EMBKSM/RV32-FullStack/docs/figs/fig_readback.png

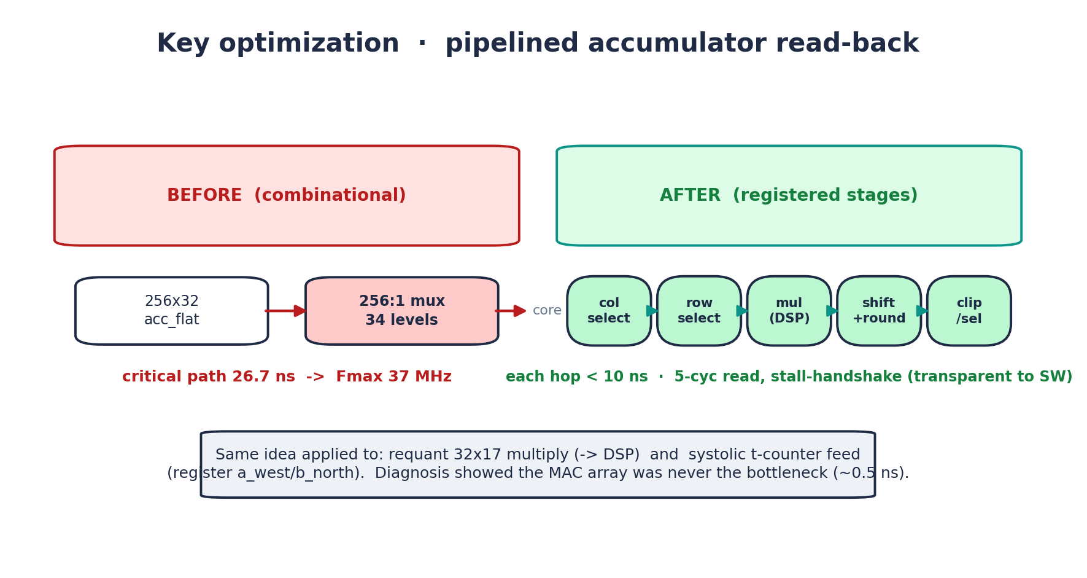
docs/figs/fig_readback.png
