EMBKSM/RV32-FullStack/docs/figs_corp/bg_blue.png

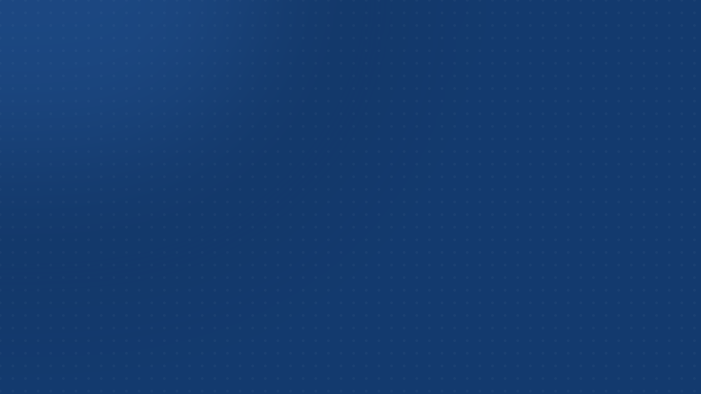
docs/figs_corp/bg_blue.png
