EMBKSM/RV32-FullStack/sim/tb_pmod_bva.vhd

-- =====================================================================
-- tb_pmod_bva.vhd  -  self-checking 3-point boundary-value testbench for the
-- Pmod peripherals, exercised through the real mmio_bridge register bus.
--
-- Loopbacks: SPI MISO<-MOSI, UART RX<-TX, I2C bus idle-high (no slave: a READ
-- returns 0xFF and a WRITE just completes, which is the defined no-device path).
-- GPIO: outputs observed on gpio_o/gpio_t; inputs driven on tb_gpio_i.
--
-- Compile with VHDL-2008 (to_hstring, std.env). See run_bva.bat.
-- Prints "PASS <id>" / "FAIL <id> ..." per case and a final
-- "BVA SUMMARY: TESTS=<n> FAIL=<m>".
-- =====================================================================
library IEEE;
use IEEE.STD_LOGIC_1164.ALL;
use IEEE.NUMERIC_STD.ALL;
library STD;
use STD.ENV.ALL;

entity tb_pmod_bva is end tb_pmod_bva;

architecture sim of tb_pmod_bva is
    constant GPIO_W : integer := 22;
    signal clk   : std_logic := '0';
    signal reset : std_logic := '1';

    signal c_addr, c_wdata, c_rdata : std_logic_vector(31 downto 0) := (others=>'0');
    signal c_wstrb : std_logic_vector(3 downto 0) := "1111";
    signal c_we, c_re, c_stall : std_logic := '0';
    signal d_rdata : std_logic_vector(31 downto 0) := (others=>'0');
    signal d_stall : std_logic := '0';
    signal d_addr, d_wdata : std_logic_vector(31 downto 0);
    signal d_wstrb : std_logic_vector(3 downto 0);
    signal d_we, d_re : std_logic;
    signal led_o : std_logic_vector(3 downto 0);
    signal sw_i, btn_i : std_logic_vector(3 downto 0) := (others=>'0');
    signal gpio_i, gpio_o, gpio_t : std_logic_vector(GPIO_W-1 downto 0) := (others=>'0');
    signal spi0_sclk,spi0_mosi,spi0_ss_n,spi0_miso : std_logic;
    signal spi1_sclk,spi1_mosi,spi1_ss_n,spi1_miso : std_logic;
    signal i2c0_scl_in,i2c0_scl_oe,i2c0_sda_in,i2c0_sda_oe : std_logic;
    signal i2c1_scl_in,i2c1_scl_oe,i2c1_sda_in,i2c1_sda_oe : std_logic;
    signal uart_tx, uart_rx : std_logic;
    signal pwm_o : std_logic_vector(3 downto 0);
    signal tb_gpio_i : std_logic_vector(GPIO_W-1 downto 0) := (others=>'0');

    constant SYS:integer:=16#00#; constant GPIO:integer:=16#20#;
    constant SPI0:integer:=16#40#; constant SPI1:integer:=16#60#;
    constant I2C0:integer:=16#80#; constant I2C1:integer:=16#A0#;
    constant UART:integer:=16#C0#; constant PWM:integer:=16#E0#;
begin
    dut : entity work.mmio_bridge
        generic map (LED_W=>4, SW_W=>4, BTN_W=>4, GPIO_W=>GPIO_W)
        port map (clk=>clk, reset=>reset,
            c_addr=>c_addr, c_wdata=>c_wdata, c_wstrb=>c_wstrb, c_we=>c_we, c_re=>c_re,
            c_rdata=>c_rdata, c_stall=>c_stall,
            d_addr=>d_addr, d_wdata=>d_wdata, d_wstrb=>d_wstrb, d_we=>d_we, d_re=>d_re,
            d_rdata=>d_rdata, d_stall=>d_stall,
            led_o=>led_o, sw_i=>sw_i, btn_i=>btn_i,
            gpio_i=>gpio_i, gpio_o=>gpio_o, gpio_t=>gpio_t,
            spi0_sclk=>spi0_sclk,spi0_mosi=>spi0_mosi,spi0_ss_n=>spi0_ss_n,spi0_miso=>spi0_miso,
            spi1_sclk=>spi1_sclk,spi1_mosi=>spi1_mosi,spi1_ss_n=>spi1_ss_n,spi1_miso=>spi1_miso,
            i2c0_scl_in=>i2c0_scl_in,i2c0_sda_in=>i2c0_sda_in,i2c0_scl_oe=>i2c0_scl_oe,i2c0_sda_oe=>i2c0_sda_oe,
            i2c1_scl_in=>i2c1_scl_in,i2c1_sda_in=>i2c1_sda_in,i2c1_scl_oe=>i2c1_scl_oe,i2c1_sda_oe=>i2c1_sda_oe,
            uart_tx=>uart_tx, uart_rx=>uart_rx, pwm_o=>pwm_o);

    spi0_miso <= spi0_mosi;
    spi1_miso <= spi1_mosi;
    uart_rx   <= uart_tx;
    gpio_i    <= tb_gpio_i;
    i2c0_scl_in <= not i2c0_scl_oe;   -- idle-high bus, no slave
    i2c0_sda_in <= not i2c0_sda_oe;
    i2c1_scl_in <= not i2c1_scl_oe;
    i2c1_sda_in <= not i2c1_sda_oe;

    clk <= not clk after 10 ns;       -- 50 MHz

    stim : process
        variable n_tests : integer := 0;
        variable n_fail  : integer := 0;
        variable rd : std_logic_vector(31 downto 0);
        variable hc : integer;

        procedure mwr(off:integer; d:std_logic_vector(31 downto 0)) is
        begin
            c_addr <= std_logic_vector(to_unsigned(16#10000000#+off,32));
            c_wdata<= d; c_we<='1'; c_re<='0';
            wait until rising_edge(clk);
            c_we<='0';
            wait until rising_edge(clk);
        end procedure;

        procedure mrd(off:integer; res:out std_logic_vector(31 downto 0)) is
        begin
            c_addr <= std_logic_vector(to_unsigned(16#10000000#+off,32));
            c_re<='1'; c_we<='0';
            wait until rising_edge(clk);
            res := c_rdata;
            c_re<='0';
            wait until rising_edge(clk);
        end procedure;

        procedure chk(id:string; got,exp:std_logic_vector(31 downto 0)) is
        begin
            n_tests := n_tests + 1;
            if got = exp then
                report "PASS " & id;
            else
                report "FAIL " & id & " got=" & to_hstring(got) & " exp=" & to_hstring(exp)
                    severity error;
                n_fail := n_fail + 1;
            end if;
        end procedure;

        procedure chk_lo(id:string; b:std_logic) is   -- expect a single bit = '0'
        begin
            n_tests := n_tests + 1;
            if b='0' then report "PASS " & id;
            else report "FAIL " & id severity error; n_fail := n_fail + 1; end if;
        end procedure;

        procedure spi_xfer(base:integer; divv:integer; ctrl:integer; txb:integer;
                           res:out std_logic_vector(31 downto 0)) is
            variable s : std_logic_vector(31 downto 0);
        begin
            mwr(base+8,  std_logic_vector(to_unsigned(divv,32)));
            mwr(base+0,  std_logic_vector(to_unsigned(ctrl,32)));
            mwr(base+12, std_logic_vector(to_unsigned(txb,32)));      -- start
            for i in 0 to 200000 loop mrd(base+4,s); exit when s(0)='0'; end loop;
            mrd(base+16,res);
        end procedure;

        procedure spi_suite(base:integer; tag:string) is
            variable r : std_logic_vector(31 downto 0);
            variable s : std_logic_vector(31 downto 0);
        begin
            -- DIV=0 (true minimum): verify the engine RUNS and the transfer COMPLETES
            -- (busy returns to 0). RX is NOT asserted here: with MOSI looped to MISO
            -- through the master's 2-FF input synchronizer, the bit period at DIV=0/1
            -- is within the 2-clk sync latency, so the first sampled bit reads the stale
            -- pre-launch value. That is a loopback artifact (a real slave's MISO is
            -- sampled correctly); data integrity is checked at DIV>=2 below.
            mwr(base+8, x"00000000"); mwr(base+0, x"00000000"); mwr(base+12, x"000000FF");
            for i in 0 to 100000 loop mrd(base+4,s); exit when s(0)='0'; end loop;
            chk_lo(tag&"-div0-done", s(0));
            -- data integrity: lowest loopback-valid divider, then bit-ordering at nominal
            spi_xfer(base,2,  0, 16#FF#, r); chk(tag&"-div2-ff", r, x"000000FF"); -- min valid
            spi_xfer(base,3,  0, 16#01#, r); chk(tag&"-div3-01", r, x"00000001"); -- LSB
            spi_xfer(base,24, 0, 16#80#, r); chk(tag&"-nom-80",  r, x"00000080"); -- MSB first
            spi_xfer(base,24, 0, 16#AA#, r); chk(tag&"-txAA",    r, x"000000AA"); -- ordering
            spi_xfer(base,8,  3, 16#A5#, r); chk(tag&"-mode3",   r, x"000000A5"); -- CPOL/CPHA=1
        end procedure;
    begin
        reset<='1'; wait for 100 ns; wait until rising_edge(clk);
        reset<='0'; wait until rising_edge(clk);

        -- ---------- SPI0 / SPI1 ----------
        spi_suite(SPI0,"SPI0");
        spi_suite(SPI1,"SPI1");

        -- ---------- GPIO ----------
        mwr(GPIO+0, x"FFFFFFFF"); mrd(GPIO+0, rd); chk("GPIO-dir-trunc", rd, x"003FFFFF");
        mwr(GPIO+4, x"002AAAAA"); wait until rising_edge(clk);
        chk("GPIO-o-pat",  std_logic_vector(resize(unsigned(gpio_o),32)), x"002AAAAA");
        chk("GPIO-t-zero", std_logic_vector(resize(unsigned(gpio_t),32)), x"00000000");
        mwr(GPIO+0, x"00200001"); mwr(GPIO+4, x"00200001"); wait until rising_edge(clk);
        chk("GPIO-o-edge", std_logic_vector(resize(unsigned(gpio_o),32)), x"00200001");
        chk("GPIO-t-edge", std_logic_vector(resize(unsigned(gpio_t),32)), x"001FFFFE");
        mwr(GPIO+0, x"00000000");
        tb_gpio_i <= "10" & x"AAAAA";
        wait until rising_edge(clk); wait until rising_edge(clk); wait until rising_edge(clk);
        mrd(GPIO+8, rd); chk("GPIO-in-pat", rd, x"002AAAAA");

        -- ---------- UART ----------
        mwr(UART+0, x"00000001"); mrd(UART+0, rd); chk("UART-div-min", rd, x"00000001");
        mwr(UART+0, x"0000FFFF"); mrd(UART+0, rd); chk("UART-div-max", rd, x"0000FFFF");
        mwr(UART+0, x"00000010");                      -- DIV=16 for loopback
        for v in 0 to 5 loop
            case v is
                when 0=> mwr(UART+8, x"00000000");
                when 1=> mwr(UART+8, x"00000001");
                when 2=> mwr(UART+8, x"00000055");
                when 3=> mwr(UART+8, x"000000AA");
                when 4=> mwr(UART+8, x"000000FE");
                when others=> mwr(UART+8, x"000000FF");
            end case;
            for i in 0 to 100000 loop mrd(UART+4, rd); exit when rd(1)='1'; end loop;
            mrd(UART+12, rd);
            case v is
                when 0=> chk("UART-rx00", rd, x"00000000");
                when 1=> chk("UART-rx01", rd, x"00000001");
                when 2=> chk("UART-rx55", rd, x"00000055");
                when 3=> chk("UART-rxAA", rd, x"000000AA");
                when 4=> chk("UART-rxFE", rd, x"000000FE");
                when others=> chk("UART-rxFF", rd, x"000000FF");
            end case;
        end loop;

        -- ---------- PWM ----------
        mwr(PWM+0, x"00000000"); mwr(PWM+4, x"00000064"); mwr(PWM+8, x"00000000");
        mwr(PWM+0, x"00000001");                       -- enable ch0, PERIOD=100, DUTY=0
        hc := 0;
        for i in 0 to 199 loop wait until rising_edge(clk); if pwm_o(0)='1' then hc:=hc+1; end if; end loop;
        chk("PWM-duty0", std_logic_vector(to_unsigned(hc,32)), x"00000000");
        mwr(PWM+8, x"00000064");                       -- DUTY=PERIOD -> 100%
        hc := 0;
        for i in 0 to 199 loop wait until rising_edge(clk); if pwm_o(0)='1' then hc:=hc+1; end if; end loop;
        chk("PWM-duty100", std_logic_vector(to_unsigned(hc,32)), x"000000C8");
        mwr(PWM+8, x"000000C8");                        -- DUTY>PERIOD -> saturate 100%
        hc := 0;
        for i in 0 to 199 loop wait until rising_edge(clk); if pwm_o(0)='1' then hc:=hc+1; end if; end loop;
        chk("PWM-sat", std_logic_vector(to_unsigned(hc,32)), x"000000C8");
        mwr(PWM+4, x"0FFFFFFF"); mrd(PWM+4, rd); chk("PWM-period-trunc", rd, x"00FFFFFF");

        -- ---------- I2C0 (FSM/decode/busy on an idle-high bus) ----------
        mwr(I2C0+8, x"0000007C"); mrd(I2C0+8, rd); chk("I2C-div",  rd, x"0000007C");
        mwr(I2C0+12,x"000000A0"); mrd(I2C0+12,rd); chk("I2C-tx",   rd, x"000000A0");
        mwr(I2C0+0, x"00000000"); mrd(I2C0+4, rd); chk_lo("I2C-cmd0-idle", rd(0)); -- empty cmd: no busy
        mwr(I2C0+12,x"000000A0"); mwr(I2C0+0, x"00000005");                        -- START|WRITE
        wait until rising_edge(clk); wait until rising_edge(clk);
        for i in 0 to 200000 loop mrd(I2C0+4, rd); exit when rd(0)='0'; end loop;
        chk_lo("I2C-wr-busyclr", rd(0));
        mwr(I2C0+0, x"00000008");                                                 -- READ, ACK=0
        for i in 0 to 200000 loop mrd(I2C0+4, rd); exit when rd(0)='0'; end loop;
        mrd(I2C0+16, rd); chk("I2C-rd-idle", rd, x"000000FF");

        report "BVA SUMMARY: TESTS=" & integer'image(n_tests) & " FAIL=" & integer'image(n_fail);
        assert n_fail = 0 report "BVA had failures" severity failure;
        finish;
    end process;
end sim;
