EMBKSM/RV32-FullStack/(commit log)

2026-04-27 feat: implement instruction fetch stage including program counter logic and cache address splitting components
2026-06-09 fix: fix ADDI gating and add synchronous reset to register_file
    - BUG-IFWB-001: Fix incorrect application of funct7[5] in ADDI instructions
    - BUG-IFWB-002: Fix state leakage between programs by adding synchronous reset to register_file
    - Completed the 1st integration test
    [register_file.vhd, rv32_core.vhd, tb_register_file.sv, tb_rv32_core_if_wb.sv]
2026-06-09 fix: resolve D-cache store-miss bug and fix testbench state leakage
    [1st Integration Test Fixes]
    - RTL (dcache_controller): Add D_SWRITE state to write store word while maintaining stall after refill.
    - TB: Move dut_run preload timing to negedge to prevent instruction fetch race condition (PC=0).
    [2nd Integration Test Fixes]
    - TB: Append halt instruction (jal x0,0) to the end of programs to prevent rolling into stale memory.
    - TB: Implement data window (0x40~0x7c) zero-clearing before each test run to eliminate state leakage.
    Result: 2nd integration test fully completed (ALL PASS).
    [axi_slave_mem.vhd, cache_unit.vhd, dcache_controller.vhd, rv32_core.vhd, rv32_soc.vhd, tb_rv32_core_if_wb.sv, tb_rv32_soc.sv]
2026-06-09 feat: complete RV32I CPU (CSR/trap + FENCE.I) and package all blocks as IP
    RTL:
    - Integrate CSR (Zicsr) + trap (ECALL/EBREAK/MRET/illegal) into rv32_core EX
    - Rebuild I-cache from IF-line blocks: icache_unit + icache_data_array +
    icache_axi_adapter; swap into rv32_soc
    - Wire FENCE.I -> I-cache invalidate (one-shot ic_fence_i)
    Verify:
    - Add icache unit/integration TBs; fix stale tb_dcache_controller (D_SWRITE)
    - Python regression ALL GREEN (incl. fault-injection); full SoC xsim ALL PASS
    - VERIFICATION_REPORT_FINAL.md, run_all_xsim.bat
    IP:
    - package_all_ip.tcl / fix_icache_adapter_ip.tcl -> ip_repo/ (30 IPs)
    [address_aligner.vhd, alu.vhd, alu_control.vhd, axi_master.vhd, bcu.vhd, cache_controller.vhd, cache_unit.vhd, comparator.vhd]
2026-06-09 feat(bd): add pipeline-register + glue modules and package them as IP for BD assembly
    Hand-assembling rv32_core in IP Integrator from leaf IPs needs glue that lives
    inline in rv32_core.vhd (not packaged). Add it as standalone modules + IPs.
    bd_assembly/:
    - ifid_reg / idex_reg / exmem_reg / memwb_reg : pipeline boundary registers
    (extracted 1:1 from rv32_core; freeze/bubble/squash + EX/MEM CSR-fold)
    - id_decode_glue : ID field slices + funct7_5 gating + jalr + zimm + csr_we
    - fencei_oneshot : FENCE.I 1-cycle invalidate pulse
    - mux2_32 / mux3_32 / orgate2 / andn2 : datapath/control glue
    - BD_WIRING_GUIDE.md : stage-by-stage netlist + per-stage IP BOM
    - bd_mux_glue.vhd : deprecated (split in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
2026-06-11 feat(soc): host-controlled RV32 platform on Zynq PL — AXI-Lite control + MMIO, bitstream
    PL platform (ip_workspace/5_Platform/):
    - mmio_bridge : cache-bypass MMIO decode (LED out / SW,BTN in) on the data bus
    - rv32_ctrl_axi : AXI4-Lite control/status slave (load imem/dmem, cpu_reset/run/
    step, read register/PC/commit-diff/data) — §4 register map
    - rv32_platform : synthesizable PL top = rv32_core + I$/D$ + RAM + MMIO + ctrl,
    with single-step/run/halt control
    mem: axi_slave_mem reworked for synthesis — synchronous (prefetch-registered)
    reads + unified byte-enable write => infers BRAM (was LUTRAM); added a
    registered host dump-read port. E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
    [address_aligner.vhd, alu.vhd, alu_control.vhd, axi_master.vhd, axi_slave_mem.vhd, bcu.vhd, cache_controller.vhd, cache_unit.vhd]
2026-06-16 feat(host): PC assembler/GUI + console + PS monitor for the AXI-Lite RV32 platform
    Host-side toolchain that assembles, loads and runs programs over UART -> the PS
    monitor -> the AXI-Lite control slave (no JTAG needed for run/debug):
    - host_app/rv32_gui.py : PySide6 assembler + register/memory/peripheral view,
    load/reset/run/step with a live register map.
    - host_app/rv32_console.py : headless assemble+load+run for scripting/regression.
    - ps_firmware/rv32_monitor.c: OCM-resident PS monitor, r/i/d/g/s/x/m/p/c/t command
    protocol at 115200 baud.
    GUI fixes from board bring-up:
    - regsReady = Signal(object) (was Signal(dict)): Shiboken c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
    [rv32_console.py, rv32_gui.py, rv32_monitor.c]
2026-06-16 feat(soc): AXI-Lite read-back of board peripherals (LED/SW/BTN)
    rv32_ctrl_axi: add R registers 0x38 LED / 0x3C SW / 0x40 BTN so the host GUI shows
    live board-peripheral state next to the CPU register/PC/commit read-back.
    ip_workspace source + packaged ip_repo copy; docs/SOC_PLATFORM_DESIGN.md section 4
    register map updated.
2026-06-16 test(cpu): re-verify full RV32I against the ISS golden model
    All 39 RV32I instructions (raw) + 20 directed programs + 100 random programs cross-
    checked against the instruction-set simulator: 39/39, 20/20, 100/100 PASS. Confirms
    the core and cached-memory path are sound -- the bring-up faults were all host/GUI/
    board-side, not RTL.
    - verification/tb_ps_regress.sv harness; BOARD_VERIFICATION_REPORT.md writeup.
2026-06-16 chore(ps): QSPI-boot scripts + DDR DQS errata workaround (PARKED - board HW fault)
    flash/: FSBL + bootgen + program_flash scripts for standalone QSPI boot. Applied the
    DQS_TO_CLK_DELAY negative-value workaround (DQS=0.0; Xilinx AR53039 / Digilent PR#25)
    and regenerated ps7_init. program_flash still failed in u-boot and a byte-lane-3
    read-back fault reproduced -> genuine DDR hardware fault on this board (RMA). PARKED:
    the JTAG run/debug flow needs no DDR, so this does not block the platform.
    (generated ps7_init, BOOT.bin, ELFs and the Vitis workspace are git-ignored.)
2026-06-16 feat(pl): MMIO Pmod peripherals on JA-JE -- 2x SPI, 2x I2C, UART, PWM, GPIO; bitstream
    PL peripherals (ip_workspace/5_Platform/) mapped into the 0x1000_0000 MMIO window
    (block=addr[7:5], reg=addr[4:2]) so RV32 assembly drives them with plain lw/sw -- no
    PS firmware/monitor/GUI change:
    - spi_master x2 (JA/JB @0x40/0x60): 8-bit full-duplex, CPOL/CPHA modes 0-3, clock
    divider, auto/manual SS, 2-FF MISO sync, busy-guarded start.
    - i2c_master x2 (JC/JD @0x80/0xA0): open-drain, START/repeated-START/STOP/WR/RD/ACK
    FSM, prescale, clock-stretch aware, RXACK capture.
    - uart_lite (JE @0xC0): 8-N-1, baud divisor, mid-bit RX sampling, RX_VALID/OVERRUN.
    - pwm_gen (JE @0xE0): 4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
2026-06-16 fix(host): robust assembler + fix README SPI example
    Assembler (rv32_gui.py and rv32_console.py, kept in sync):
    - li now assembles full 32-bit immediates (lui+addi) instead of silently
    truncating to 12 bits; lui-only when the low 12 bits are zero; correct
    signed remainder including the round-up / negative-low case.
    - add pseudo-branches beqz/bnez/bgez/bltz/blez/bgtz -> base branch vs x0.
    - range-check every immediate and reject out-of-range instead of masking:
    I-type ALU + load/store offsets (12-bit signed), shifts (shamt 0..31),
    lui/auipc (20-bit), branches (+-4 KiB, even), jal (+-1 MiB, even).
    - mem_operand rejects bare-hex offsets like ff(x1) with a clear message
    (require 0x for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
    [rv32_console.py, rv32_gui.py, test_assembler.py]
2026-06-18 feat(npu): INT8 systolic GEMM accelerator + LUTRAM caches + generic 16x16 scale-up
    PL area optimization
    - Convert I$/D$ data arrays to LUTRAM (distributed RAM) to free slices for the NPU.
    NPU (INT8 output-stationary systolic GEMM, uncached MMIO slave @ 0x3000_0000)
    - npu_pe: DSP48E1 INT8 MAC (DSP_USE generic selects DSP vs LUT fabric).
    - npu_array: NxN mesh, generic N + DSP_BUDGET hybrid DSP/LUT mapping.
    - npu_top: control FSM, skew feeder, distributed-RAM scratchpads, MMIO decode,
    on-chip requantization (INT32 -> mult/shift/clip -> INT8, CFG @ 0x000C).
    - mmio_bridge: NPU window decode (is_npu, addr[31:28]=0x3); now wires npu_top16.
    16x16 scale-up
    - Parameterized array (generic N, defaul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
2026-06-22 feat(npu): on-board 16x16 GEMM verified via ctrl_axi @30.3MHz + arch diagram
    ctrl_axi-direct JTAG drive bypasses dead DDR/OCM: load RV32 imem, run, read C. 2x2 tile GEMM on real XC7Z020 => C=[[39,53],[17,23]] matches golden. Key: configparams force-mem-access 1 enables XSDB PL-AXI access. Adds jtag_gemm_test.tcl, npu16_demo.s, BOARD_GEMM_RESULT.md, run_*.bat, architecture_block_diagram.svg, HANDOFF board-bringup.
2026-06-22 perf(npu): pipeline NPU read-back -> Fmax 37->94.3 MHz (16x16 SoC)
    Only failing paths were the NPU read-back, not the MAC array (PE->PE ~0.5ns). Registered pipeline stages, transparent to SW via mem_stall/rd_valid handshake: (1) 256:1 acc_flat select -> col/row stages (26.7->13.3ns, 37->75MHz, build 1h17m->8min); (2) requant 32x17 multiply -> mul(DSP)/shift/clip stages (WNS -3.29->-0.60ns @100MHz -> Fmax 94.3MHz, failing EPs 3196->817). npu_top 5-cycle read FSM + re/rd_valid; mmio_bridge stalls NPU reads. Re-verified 18,688/0. Board op 90.9MHz (FCLK0/11). Adds PERFORMANCE_FMAX.md, build/analyze tcl, jtag_gemm_test_100, rv32_16x16_100mhz.bit.
    [address_aligner.vhd, alu.vhd, alu_control.vhd, axi_master.vhd, bcu.vhd, cache_controller.vhd, comparator.vhd, control_unit.vhd]
2026-06-22 docs(npu): board test prepped @90.9MHz (FCLK0/11); JTAG/DAP degraded -> power-cycle pending
    3 board-test attempts hit DAP AHB AP transaction error (no A9 targets) = recurring board JTAG degradation needing a power-cycle; not a logic issue (94.3MHz proven in sim 18,688-check + post-route timing). jtag_gemm_test_100.tcl set to 90.9MHz (0x00100B00) with the 94MHz bitstream, self-validating. Cleans .git litter from sandbox commits.
    [mmio_bridge.vhd, npu_top.vhd, tb_npu_scale16.sv]
2026-06-22 test(npu): board GEMM PASS @90.9MHz on real XC7Z020 (94MHz build, C=39/53/17/23)
    After power-cycle: ctrl_axi drives RV32+16x16 NPU, reads C=[[39,53],[17,23]]=golden, BOARD-GEMM-90MHZ PASS, xsct exit=0. Fmax-94.3MHz pipelined-readback build runs correctly on silicon @90.9MHz (FCLK0/11); 5-cycle stall handshake works end-to-end.
    [mmio_bridge.vhd, npu_top.vhd, tb_npu_scale16.sv]
2026-06-22 perf(npu): close 100 MHz + board-verify (register scratchpad feed) -- Fmax 37->100
    Worst paths were ALL the systolic t-counter feed (t_reg->(t-n)->scratchpad->DSP A), not the core. Registered a_west/b_north in npu_top: path split at a flop, input stream shifts 1 cycle (t_last+1), bit-identical (18,688-check pass). WNS -0.602->+0.085ns @100MHz, 817->0 failing EPs. 100MHz=FCLK0/10. BOARD @100MHz GEMM C=[[39,53],[17,23]]=golden PASS. rv32_16x16_100mhz.bit=100MHz build; 94mhz_verified.bit preserves v3.
2026-06-22 perf(npu): close 100 MHz + board-verify (register scratchpad feed) -- Fmax 37->100
    Worst paths were ALL the systolic t-counter feed (t_reg->(t-n)->scratchpad->DSP A), not the core. Registered a_west/b_north in npu_top: long path split at a flop, input stream shifts 1 cycle uniformly (t_last+1), bit-identical (18,688-check pass). WNS -0.602->+0.085ns @100MHz, 817->0 failing endpoints; new worst path core-store->NPU-scratchpad-write +0.085 (met). 100MHz=FCLK0/10 (no MMCM). BOARD @100MHz: ctrl_axi GEMM C=[[39,53],[17,23]]=golden, PASS, xsct exit=0. rv32_16x16_100mhz.bit=100MHz build; rv32_16x16_94mhz_verified.bit=v3 94MHz backup. Consolidates partial sandbox-commit state.
    [mmio_bridge.vhd, npu_top.vhd, tb_npu_scale16.sv]
2026-06-23 perf(clk): PL MMCM (FCLK0 100->106) -> board-verified 106 MHz; retiming pushes Fmax to 110.8
    Beyond the clean 100MHz: synthesis retiming (Flow_PerfOptimized_high) lifts Fmax 100.9->110.8 MHz. New wall = RV32 load-use hazard path (exmem_reg_write->ifid CE, ~75% route) -- fundamental to the 5-stage pipeline; blind Pblock floorplan was neutral. 110.8 doesn't land on a clean FCLK0 divisor (/9=111.1 too fast, /10=100 wastes it), so a PL MMCM (clk_wiz in rv32_top.bd) synthesizes 106 MHz: FCLK0(100)->MMCM->106->PL. WNS -0.118ns @106 slow-corner (4 EPs) closes on real silicon: on-board ctrl_axi GEMM C=[[39,53],[17,23]]=golden, BOARD-GEMM-MMCM-106MHZ PASS, xsct exit=0. Adds build_npu16_mmcm/maxf/fp.t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
2026-06-24 fix(clk)+feat(gui,docs): clean 106 MHz close (0 critical warnings), dark GUI restyle, result deck
    Timing — the 106 MHz MMCM build now MEETS timing AND has a clean methodology
    report (was WNS -0.118 ns with 2 Critical Warnings):
    * Root-caused the 2 methodology Critical Warnings (TIMING-2 / TIMING-4): the
    clk_wiz IP re-created a primary clock on its input pin clk_in1, which the PS
    clock clk_fpga_0 (100 MHz) already drives -> redundant clock redefinition on
    the clock tree. Removed the redundant `create_clock [get_ports clk_in1]`
    (+ set_input_jitter) so clk_fpga_0 is the single master and the MMCM derives
    106 MHz from it.
    * Re-closed timing at the synthesis root (not an impl-stage ba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
2026-06-25 refactor(repo): standardize layout (rtl/sim/fpga/sw/docs) + untrack generated artifacts
    Reorganize into a conventional hierarchy and stop tracking regenerable build output.
    Layout:
    rtl/{core,npu,soc,common} <- ip_workspace/ (single VHDL source of truth)
    sim/ <- verification/ (TB sources + py harnesses + .f lists)
    fpga/{scripts,constraints,flash} <- build TCL, XDC, boot/jtag scripts
    sw/{firmware,host} <- ps_firmware (A9 monitor) + host_app (Python GUIs)
    docs/ <- all .md specs/reports + figures (root docs consolidated)
    archive/legacy_bd/ <- bd_assembly (dead hand-wired BD glue, kept for refer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
2026-06-25 feat(gpu): SIMT-lite vector coprocessor (8-lane, LUT-based) @ 0x4xxx_xxxx
    A small data-parallel "GPU" attached to the RV32 SoC like the NPU: one
    instruction stream drives 8 lanes in lockstep with a per-lane predicate
    mask (SIMT-lite). Lanes are LUT-based (multiplier use_dsp="no") so all
    DSP48 stay with the NPU -- fits the ~38k free LUT / 18 free DSP headroom.
    RTL (rtl/gpu/): gpu_pkg (ISA), gpu_lane (32-bit ALU + LUT multiplier),
    gpu_core (1-PC lockstep datapath, banked scratchpad, mask predication),
    gpu_top (MMIO slave: CTRL/STATUS/IMEM/scratchpad windows). Wired into
    rtl/soc/mmio_bridge.vhd as the 0x4 window -- twin of the NPU's 0x3,
    single-cycle, cache-bypassed.
    ISA: banked vector load/s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
2026-06-25 feat(multicore): dual-core RV32 cluster (SPMD, shared scratchpad + barrier)
    Two unmodified rv32_core instances (ideal memory, mem_stall=0) sharing one
    rv32_shared block: per-port hart id (A->0, B->1), one-shot barrier, and a
    shared scratchpad (A>B>T write priority), routed at data addr bit31=1
    (0x8000_0000+); bit31=0 is each core's private 4 KiB imem/dmem. No core
    edit (mhartid stays 0; the id comes from the shared block per port).
    Demo: the SAME SPMD program (sim/multicore/spmd.s, assembled by the project
    assembler) runs on both cores; each reads its hart id and computes its half
    of C[i]=A[i]+B[i] in the shared scratchpad -> hart0 does C[0..3], hart1
    C[4..7], result [11,22,..,88].
    Verify: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
2026-06-25 chore: track sim launcher scripts + gitignore exception
    The run_*.bat ignore (originally for the removed run_all_xsim.bat) was also
    hiding sim/gpu/run_gpu.bat and sim/multicore/run_dual.bat, which the README
    references. Add explicit !exceptions and track both launchers.
2026-06-26 refactor(gpu): 16x16 DSP multiply per lane (was 32x32 LUT) + synth notes
    OOC synthesis showed the use_dsp="no" 32x32 LUT multiply (x8 lanes) was
    impractical: ~16 min synth, ~16k LUT. Switch to a 16x16->32 signed multiply
    mapped to one DSP48E1 per lane -> 8 DSP total (fits the ~18 free after the
    NPU); "Finished Synthesize" drops to ~24 s. C golden model updated to match
    (16-bit operands; exact for the demo kernels -- ALL GOLDEN CHECKS PASS).
    docs/GPU_DESIGN.md gains a synthesis-notes section, also flagging the
    async-read scratchpad inferring 65536 FF -> backing the scratchpad/imem with
    BRAM (sync read) + mem_stall pipelining is the next implementation refinement.
    Sim correctness (xsim, all 3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
    [gpu_lane.vhd, gpu_model.c]
2026-06-28 perf(gpu): pipeline vector-ALU + register BRAM addr -> 100 MHz timing MET
    Close GPU OOC timing at 100 MHz (xc7z020-1): WNS -3.975 -> +0.032 ns,
    0 failing endpoints of 7825.
    - gpu_core: 3-cycle vector-ALU pipeline (S_RUN->S_EX->S_WB) isolates the
    16x16 DSP multiply in its own cycle; synth -retiming pulls the operand
    registers into the DSP A/B/CREG. (-3.975 -> -0.338)
    - gpu_core: register the scratchpad row index (ld_row_r); VLD becomes
    3-cycle / VST 2-cycle so the BRAM address port sits off the
    pc->imem->scalar-adder path. (-0.338 -> +0.032 MET; limiter now SADDI)
    - gpu_ooc.xdc: 10 ns (100 MHz) OOC clock. synth_impl_gpu.tcl: retiming +
    Explore place/route + stable phys_opt; post-ro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
    [gpu_core.vhd, tb_gpu.vhd]
2026-06-28 chore(multicore,repo): OOC timing analysis + Vivado scratch cleanup
    - docs/MULTICORE_TIMING.md: dual-core OOC findings. rv32_core meets 100 MHz
    (WNS +0.110 ns; 2261 LUT / 2815 FF / 0 BRAM / 0 DSP), so 2x core fits and
    closes. The shared scratchpad + private imem/dmem are combinational sim
    coding that needs BRAM backing for a real impl (same pattern as the GPU
    scratchpad fix; rv32_shared is 3-port so a bit more involved).
    - sim/{gpu,multicore}: track the OOC synth/impl + xsim run scripts (.tcl/.xdc).
    - .gitignore: ignore *.dmp, hs_err_pid*, clockInfo.txt (Vivado scratch).
    - remove stray Vivado scratch (hs_err crash dump + clockInfo.txt).
2026-06-28 docs(soc): full integration synth -- core+NPU+GPU fits @ DSP 218/220
    OOC impl of rv32_platform (core + caches + mmio_bridge -> NPU16 + GPU +
    peripherals) on xc7z020-1 @ 100 MHz:
    - Fits: 21368 LUT (40%) / 12761 FF (12%) / 16 BRAM (11%) / 218 DSP (99%).
    The GPU's 16 DSP slot into the ~18 free after the NPU's ~202.
    - Timing: WNS -0.220 ns, 12/58742 failing endpoints (plain flow, no
    retiming/Explore/phys_opt). Limiter = GPU-internal SBNZ/pc path, the same
    class the standalone GPU closed to +0.032 with those directives; closing
    the integration is the next step.
    - fpga/scripts/synth_platform_ooc.tcl + platform_ooc.xdc to reproduce.
2026-06-29 docs(soc): integration timing is DSP-congestion-bound at 99% (218/220)
    Closing the -0.220 ns integration WNS stalled: with DSP at 218/220 the
    place/route/phys_opt passes have almost no free fabric and grind for tens of
    minutes with the GPU pc/SBNZ path stuck (route ~69% of the path = pure
    congestion). That same path closes to +0.032 standalone, so it's a
    placement-congestion artifact, not logic.
    Recommended close (documented in SOC_INTEGRATION.md): GPU 16 -> 8 DSP (one
    DSP/lane doing A*B and A*B+C) for routing headroom -> 210/220; or a Pblock
    floorplan; or the full board-project build. Board precedent (core+NPU GEMM
    ran on silicon at WNS -0.118 @106MHz slow corner) => the integration is
    sil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
2026-06-29 Unified NPU/GPU fabric: GPU borrows 8 NPU PE DSPs (0 extra DSP)
    Dual-mode npu_pe: one DSP48E1 does NPU INT8 MAC (A*B+P accumulate) OR a GPU lane multiply-add (A*B+C), runtime mode-selected -> synth-proven exactly 1 DSP per PE. The 8 GPU lanes reuse 8 row-0 NPU PE DSPs over a shared bus (npu_array/top/top16 <-> gpu_core/top <-> mmio_bridge). Full 16x16 NPU + 8-lane GPU = 202 DSP (was 210 separate, won't route on XC7Z020); 202 = the silicon-proven core+NPU point. tb_unified: vadd / saxpy(VMUL) / relu / vmac(A*B+C) ALL PASS on the shared DSPs. See docs/UNIFIED_NPU_GPU.md.
    [gpu_core.vhd, gpu_lane.vhd, gpu_top.vhd, mmio_bridge.vhd, npu_array.vhd, npu_pe.vhd, npu_pe_dual_wrap.vhd, npu_top.vhd]
2026-06-29 Board bitstream: unified NPU/GPU SoC @100MHz (202 DSP, routed, WNS -0.054)
    Version-bump the platform IP on each package so Vivado re-synthesizes the unified fabric from current source (fixes the stale-cache 210-DSP build). Add the Zybo Z7-20 pin XDCs to the impl constraint set. xc7z020 result: 202/220 DSP, 0 failed nets, hold met (WHS +0.045), setup WNS -0.054 @100MHz after post-route phys_opt (Fmax ~99.5MHz). Bitstream fpga/flash/rv32_unified_100mhz.bit (3.9MB) generated. docs/UNIFIED_NPU_GPU.md updated with the board result.
2026-06-29 Silicon-verified: unified NPU GEMM + GPU kernel on XC7Z020 @100MHz
    Flashed rv32_unified_100mhz.bit to the Zybo Z7-20 and drove the RV32 core via ctrl_axi (JTAG). NPU GEMM -> C=39,53,17,23 (golden). GPU kernel (VMUL 6*7=42 + lane id, executed on the SHARED NPU DSPs) -> lanes=42,43,44,45 (golden). The same 8 DSP48E1s run INT8 systolic MAC (NPU mode) and the GPU multiply-add (GPU mode) on real silicon @100MHz. Adds JTAG test scripts flash/jtag_unified_{gemm,gpu}.tcl + GPU driver sw/host/gpu_board_demo.s. docs/UNIFIED_NPU_GPU.md updated with the silicon results.
2026-06-30 README: comprehensive rewrite - full SoC architecture + usage + silicon results
    Introduces and explains the whole SoC: RV32I 5-stage core (I$/D$, Zicsr/trap/FENCE.I), 16x16 INT8 systolic NPU, 8-lane SIMT-lite GPU, the unified shared-DSP fabric (GPU borrows 8 NPU PE DSPs -> 202 DSP, 0 extra), Pmod MMIO peripherals, dual-core, and the Zynq PS-monitor + host link. Adds memory map, repo layout, silicon-verified results (WNS -0.054 @100MHz, 14/14 on-board), and end-to-end usage (sim, bitstream, board bring-up, live GUI/console, comprehensive board test). Adds the referenced board scripts + sw/host/gen_board_tests.py + port_probe.py.
2026-07-01 docs(README): replace ASCII block with rendered SVG system diagram
    Add docs/system_architecture.svg (PC -> Zynq PS ARM -> Zynq PL: ctrl_axi, RV32I core, mmio_bridge -> Pmod/NPU/GPU, unified shared-DSP fabric) and embed it in the README in place of the plain-text block.
